johnrenner94/Analog-Audio-Amplifier-with-JFET-Saturation/schematic.pdf

# Audio Preamp w/ Soft JFET Saturation

# 209.88422µA 3.3087692V

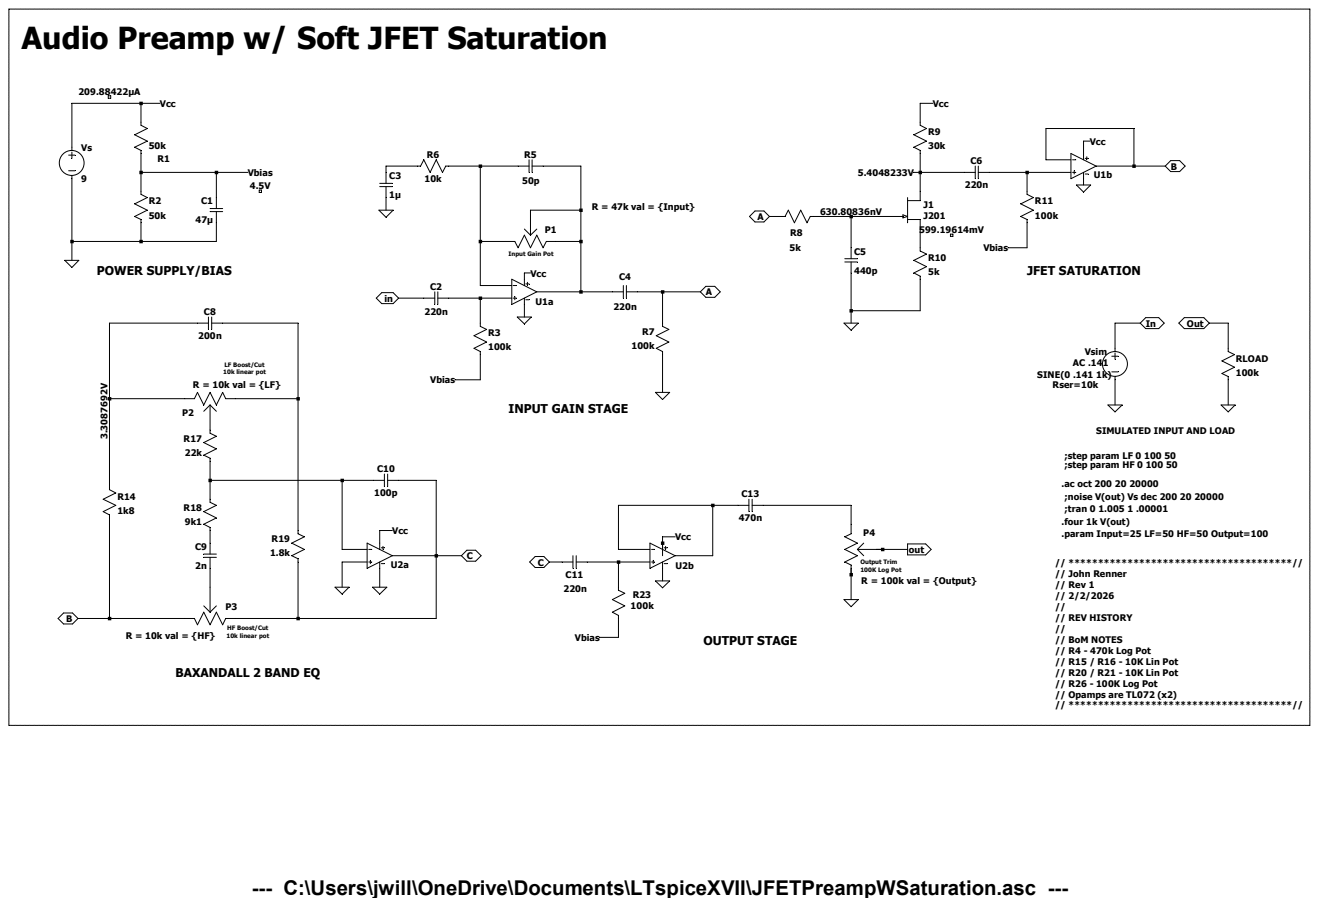
[picture p11: page 1]

SIMULATED INPUT AND LOAD

;step param LF 0 100 50
;step param HF 0 100 50
.ac oct 200 20 20000
;noise V(out) Vs dec 200 20 20000
;tran 0 1.005 1 .00001
.four 1k V(out)
.param Input=25 LF=50 HF=50 Output=100

--- C:\Users\jwill\OneDrive\Documents\LTspiceXVII\JFETPreampWSaturation.asc ---
