johnrenner94/Analog-Audio-Amplifier-with-JFET-Saturation/ltspice_components/pot.asc

R1: res; {x1}
R2: res; {x2}
Named nets: A, C, B
.param x1 = R*(val/100) + 1m
.param x2 = R*(1-(val/100)) + 1m
