johnrenner94/Analog-Audio-Amplifier-with-JFET-Saturation/simulation.asc

C1: cap; 47µ
C2: cap; 220n
C3: cap; 1µ
C4: cap; 220n
C5: cap; 440p
C6: cap; 220n
C8: cap; 200n
C9: cap; 2n
C10: cap; 100p
C11: cap; 220n
C13: cap; 470n
J1: njf; J201
P1: pot; R = 47k val = {Input}
P2: pot; R = 10k val = {LF}
P3: pot; R = 10k val = {HF}
P4: pot; R = 100k val = {Output}
R1: res; 50k
R2: res; 50k
R3: res; 100k
R5: cap; 50p
R6: res; 10k
R7: res; 100k
R8: res; 5k
R9: res; 30k
R10: res; 5k
R11: res; 100k
R14: res; 1k8
R17: res; 22k
R18: res; 9k1
R19: res; 1.8k
R23: res; 100k
RLOAD: res; 100k
U1a: UniversalOpAmp
U1b: UniversalOpAmp
U2a: UniversalOpAmp
U2b: UniversalOpAmp
Vs: voltage; 9
Vsim: voltage; SINE(0 .141 1k); AC .141; Rser=10k
Named nets: Vcc, 0, Vbias, out, in, B, A, C, Out, In
Input Gain Pot
LF Boost/Cut
10k linear pot
HF Boost/Cut
10k linear pot
INPUT GAIN STAGE
JFET SATURATION
BAXANDALL 2 BAND EQ
OUTPUT STAGE
Output Trim
100K Log Pot
POWER SUPPLY/BIAS
// **************************************//
// John Renner
// Rev 1
// 2/2/2026
// 
// REV HISTORY
// 
// BoM NOTES
// R4 - 470k Log Pot
// R15 / R16 - 10K Lin Pot
// R20 / R21 - 10K Lin Pot
// R26 - 100K Log Pot
// Opamps are TL072 (x2)
// **************************************//
Audio Preamp w/ Soft JFET Saturation
;noise V(out) Vs dec 200 20 20000
;tran 0 1.005 1 .00001
.four 1k V(out)
.ac oct 200 20 20000
SIMULATED INPUT AND LOAD
.param Input=25 LF=50 HF=50 Output=100
;step param LF 0 100 50
;step param HF 0 100 50
